simonbreit-dev/macroboard/electronics/makroboard.kicad_pcb

## KiCad design electronics/makroboard.kicad_pcb (2026-11-06)

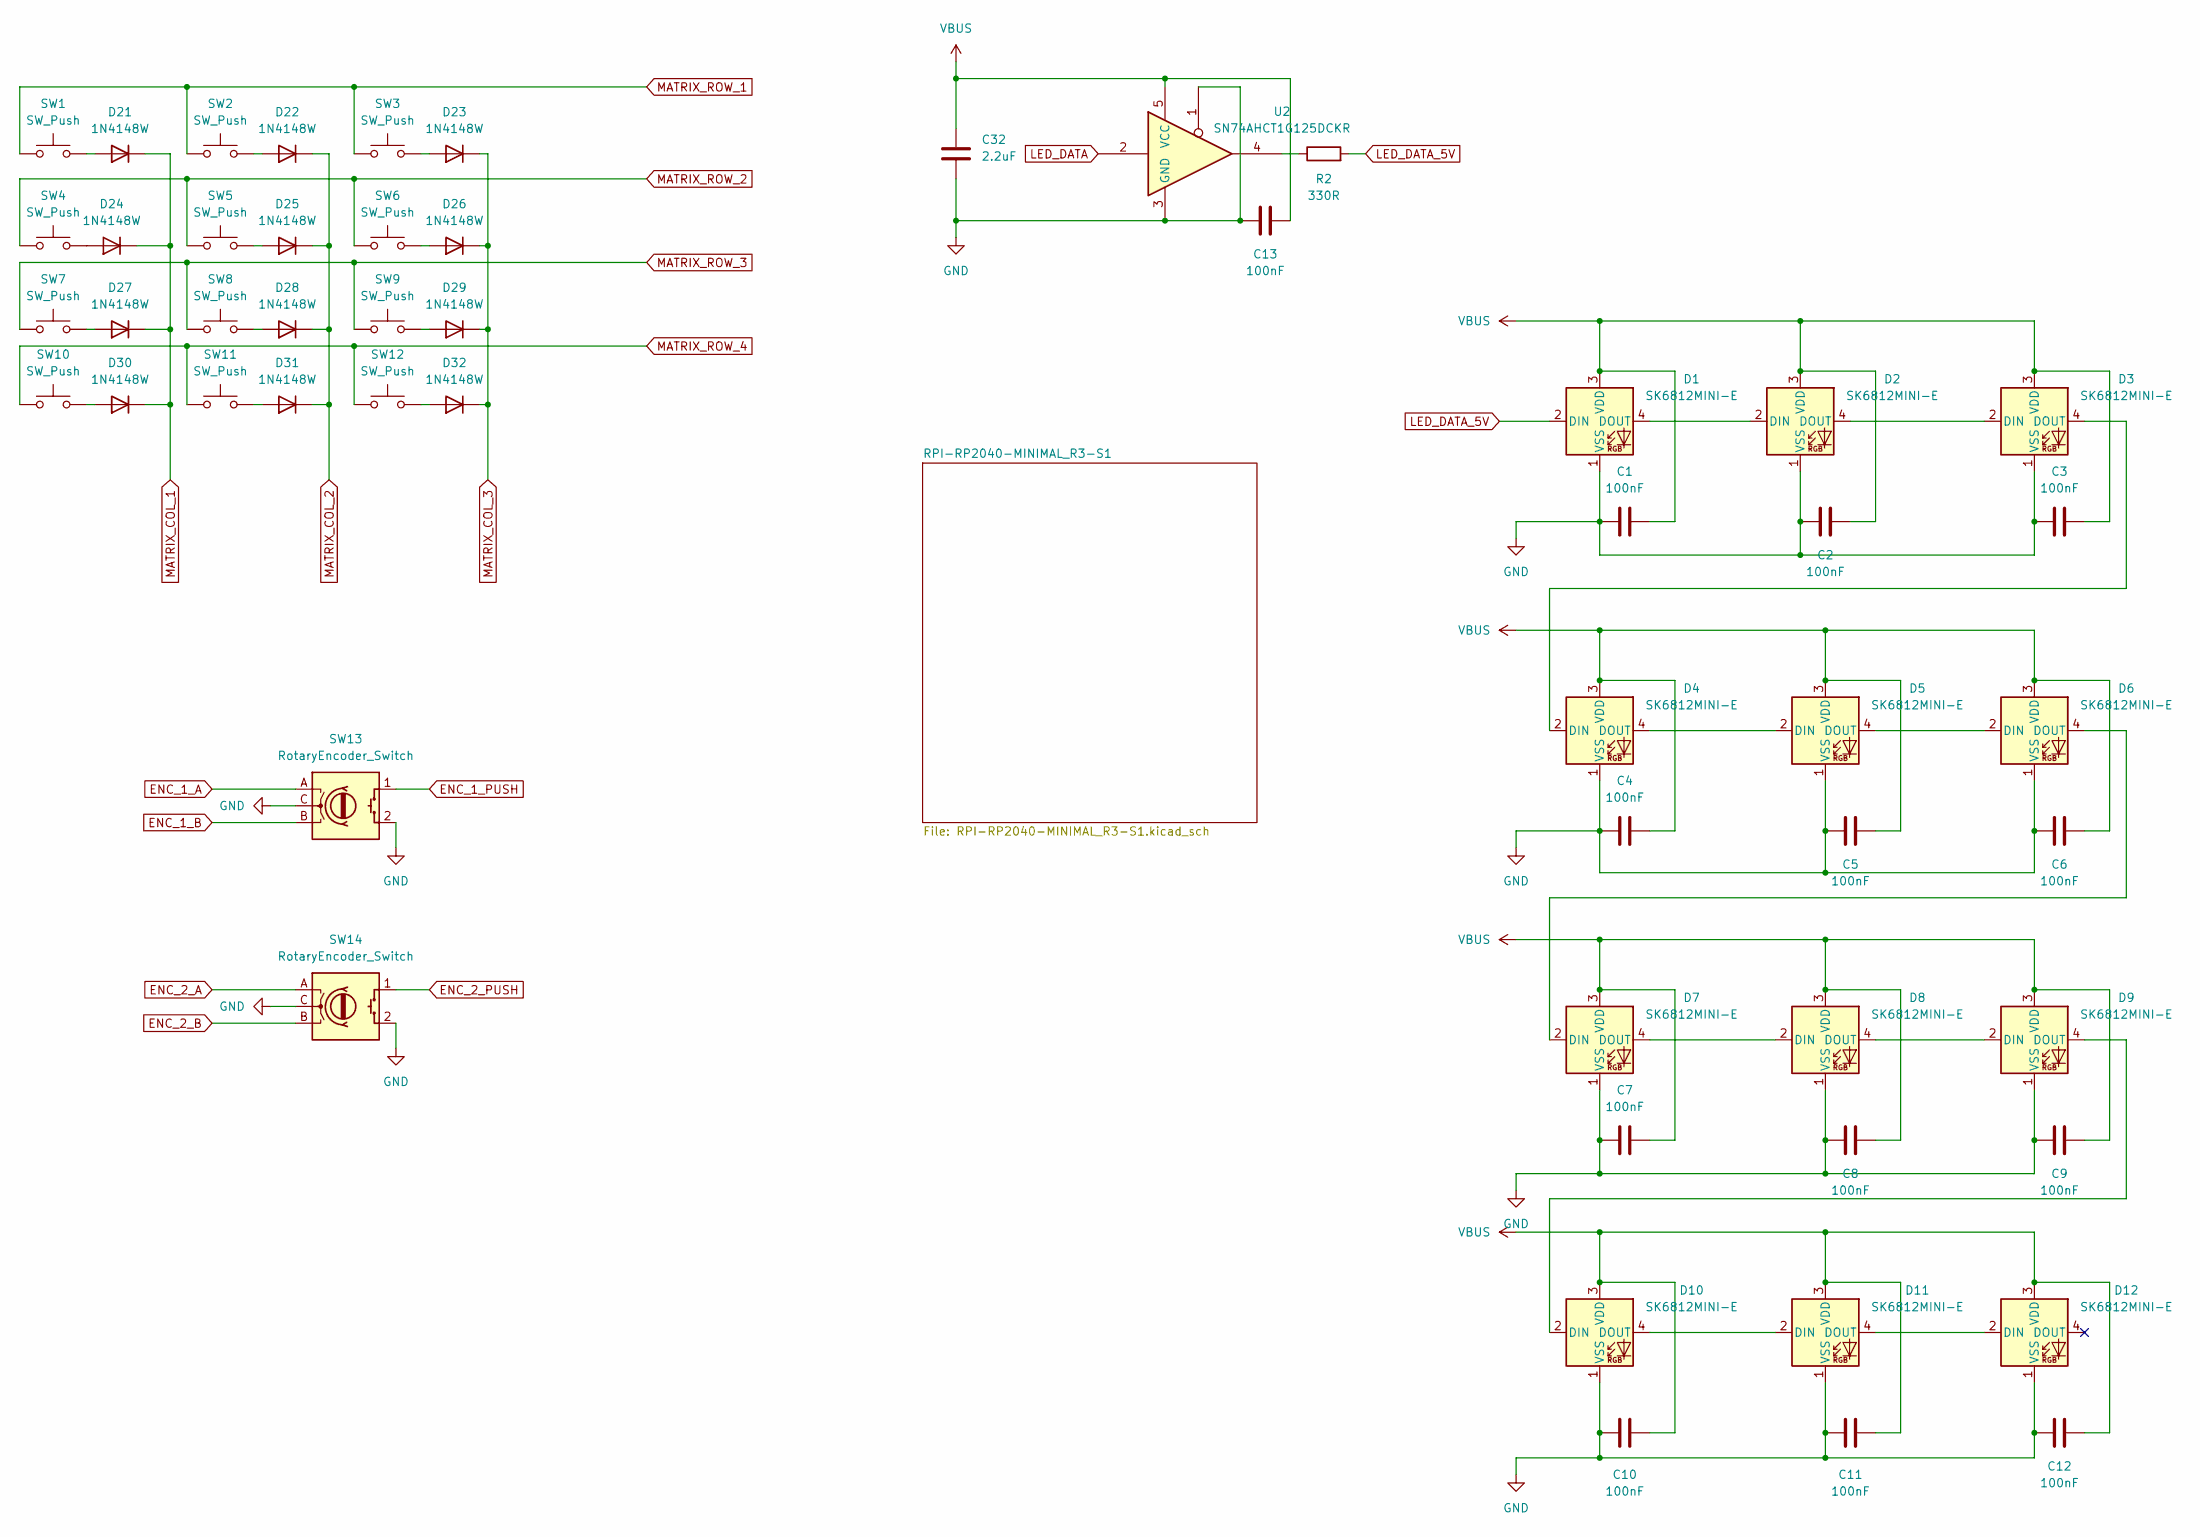
[picture p1: schematic makroboard.kicad_sch]

Parts:
C1: 100nF; C1_C_0805_2012Metric; manufacturer_pn CC0805KRX7R9BB104; LCSC C49678
C2: 100nF; C2_C_0805_2012Metric; manufacturer_pn CC0805KRX7R9BB104; LCSC C49678
C3: 100nF; C3_C_0805_2012Metric; manufacturer_pn CC0805KRX7R9BB104; LCSC C49678
C4: 100nF; C4_C_0805_2012Metric; manufacturer_pn CC0805KRX7R9BB104; LCSC C49678
C5: 100nF; C5_C_0805_2012Metric; manufacturer_pn CC0805KRX7R9BB104; LCSC C49678
C6: 100nF; C6_C_0805_2012Metric; manufacturer_pn CC0805KRX7R9BB104; LCSC C49678
C7: 100nF; C7_C_0805_2012Metric; manufacturer_pn CC0805KRX7R9BB104; LCSC C49678
C8: 100nF; C8_C_0805_2012Metric; manufacturer_pn CC0805KRX7R9BB104; LCSC C49678
C9: 100nF; C9_C_0805_2012Metric; manufacturer_pn CC0805KRX7R9BB104; LCSC C49678
C10: 100nF; C10_C_0805_2012Metric; manufacturer_pn CC0805KRX7R9BB104; LCSC C49678
C11: 100nF; C11_C_0805_2012Metric; manufacturer_pn CC0805KRX7R9BB104; LCSC C49678
C12: 100nF; C12_C_0805_2012Metric; manufacturer_pn CC0805KRX7R9BB104; LCSC C49678
C13: 100nF; C13_C_0805_2012Metric; manufacturer_pn CC0805KRX7R9BB104; LCSC C49678
C32: 2.2uF; C32_C_0805_2012Metric; manufacturer_pn CL21B225KOFNNNE; LCSC C28234
D1: SK6812MINI-E; D1_LED_SK6812MINI-E_3.2x2.8mm_P1.5mm_ReverseMount; manufacturer_pn SK6812MINI-E; LCSC C5149201
D2: SK6812MINI-E; D2_LED_SK6812MINI-E_3.2x2.8mm_P1.5mm_ReverseMount; manufacturer_pn SK6812MINI-E; LCSC C5149201
D3: SK6812MINI-E; D3_LED_SK6812MINI-E_3.2x2.8mm_P1.5mm_ReverseMount; manufacturer_pn SK6812MINI-E; LCSC C5149201
D4: SK6812MINI-E; D4_LED_SK6812MINI-E_3.2x2.8mm_P1.5mm_ReverseMount; manufacturer_pn SK6812MINI-E; LCSC C5149201
D5: SK6812MINI-E; D5_LED_SK6812MINI-E_3.2x2.8mm_P1.5mm_ReverseMount; manufacturer_pn SK6812MINI-E; LCSC C5149201
D6: SK6812MINI-E; D6_LED_SK6812MINI-E_3.2x2.8mm_P1.5mm_ReverseMount; manufacturer_pn SK6812MINI-E; LCSC C5149201
D7: SK6812MINI-E; D7_LED_SK6812MINI-E_3.2x2.8mm_P1.5mm_ReverseMount; manufacturer_pn SK6812MINI-E; LCSC C5149201
D8: SK6812MINI-E; D8_LED_SK6812MINI-E_3.2x2.8mm_P1.5mm_ReverseMount; manufacturer_pn SK6812MINI-E; LCSC C5149201
D9: SK6812MINI-E; D9_LED_SK6812MINI-E_3.2x2.8mm_P1.5mm_ReverseMount; manufacturer_pn SK6812MINI-E; LCSC C5149201
D10: SK6812MINI-E; D10_LED_SK6812MINI-E_3.2x2.8mm_P1.5mm_ReverseMount; manufacturer_pn SK6812MINI-E; LCSC C5149201
D11: SK6812MINI-E; D11_LED_SK6812MINI-E_3.2x2.8mm_P1.5mm_ReverseMount; manufacturer_pn SK6812MINI-E; LCSC C5149201
D12: SK6812MINI-E; D12_LED_SK6812MINI-E_3.2x2.8mm_P1.5mm_ReverseMount; manufacturer_pn SK6812MINI-E; LCSC C5149201
D21: 1N4148W; D21_D_SOD-123; manufacturer_pn 1N4148W; LCSC C81598
D22: 1N4148W; D22_D_SOD-123; manufacturer_pn 1N4148W; LCSC C81598
D23: 1N4148W; D23_D_SOD-123; manufacturer_pn 1N4148W; LCSC C81598
D24: 1N4148W; D24_D_SOD-123; manufacturer_pn 1N4148W; LCSC C81598
D25: 1N4148W; D25_D_SOD-123; manufacturer_pn 1N4148W; LCSC C81598
D26: 1N4148W; D26_D_SOD-123; manufacturer_pn 1N4148W; LCSC C81598
D27: 1N4148W; D27_D_SOD-123; manufacturer_pn 1N4148W; LCSC C81598
D28: 1N4148W; D28_D_SOD-123; manufacturer_pn 1N4148W; LCSC C81598
D29: 1N4148W; D29_D_SOD-123; manufacturer_pn 1N4148W; LCSC C81598
D30: 1N4148W; D30_D_SOD-123; manufacturer_pn 1N4148W; LCSC C81598
D31: 1N4148W; D31_D_SOD-123; manufacturer_pn 1N4148W; LCSC C81598
D32: 1N4148W; D32_D_SOD-123; manufacturer_pn 1N4148W; LCSC C81598
R2: 330R; R2_R_0805_2012Metric; manufacturer_pn 0805W8F3300T5E; LCSC C17630
SW1: SW_Push; SW1_SW_choc_v2_1u
SW2: SW_Push; SW2_SW_choc_v2_1u
SW3: SW_Push; SW3_SW_choc_v2_1u
SW4: SW_Push; SW4_SW_choc_v2_1u
SW5: SW_Push; SW5_SW_choc_v2_1u
SW6: SW_Push; SW6_SW_choc_v2_1u
SW7: SW_Push; SW7_SW_choc_v2_1u
SW8: SW_Push; SW8_SW_choc_v2_1u
SW9: SW_Push; SW9_SW_choc_v2_1u
SW10: SW_Push; SW10_SW_choc_v2_1u
SW11: SW_Push; SW11_SW_choc_v2_1u
SW12: SW_Push; SW12_SW_choc_v2_1u
SW13: RotaryEncoder_Switch; SW13_Bourns-PEC11R-4220F-S0024-0-0-0
SW14: RotaryEncoder_Switch; SW14_Bourns-PEC11R-4220F-S0024-0-0-0
U2: SN74AHCT1G125DCKR; U2_SOT-353_SC-70-5; manufacturer_pn SN74AHCT1G125DCKR; LCSC C350557

Connections:
ENC_1_A: SW13.A; also elsewhere on the board
ENC_1_B: SW13.B; also elsewhere on the board
ENC_1_PUSH: SW13.1 (S1); also elsewhere on the board
ENC_2_A: SW14.A; also elsewhere on the board
ENC_2_B: SW14.B; also elsewhere on the board
ENC_2_PUSH: SW14.1 (S1); also elsewhere on the board
GND: C1.2, C2.2, C3.2, C4.2, C5.2, C6.2, C7.2, C8.2, C9.2, C10.2, C11.2, C12.2, C13.2, C32.2, D1.1 (VSS), D2.1 (VSS), D3.1 (VSS), D4.1 (VSS), D5.1 (VSS), D6.1 (VSS), D7.1 (VSS), D8.1 (VSS), D9.1 (VSS), D10.1 (VSS), D11.1 (VSS), D12.1 (VSS), SW13.2 (S2), SW13.C, SW14.2 (S2), SW14.C, U2.1, U2.3 (GND); also elsewhere on the board
LED_DATA: U2.2; also elsewhere on the board
LED_DATA_5V: D1.2 (DIN), R2.2
MATRIX_COL_1: D21.1 (K), D24.1 (K), D27.1 (K), D30.1 (K); also elsewhere on the board
MATRIX_COL_2: D22.1 (K), D25.1 (K), D28.1 (K), D31.1 (K); also elsewhere on the board
MATRIX_COL_3: D23.1 (K), D26.1 (K), D29.1 (K), D32.1 (K); also elsewhere on the board
MATRIX_ROW_1: SW1.1, SW2.1, SW3.1; also elsewhere on the board
MATRIX_ROW_2: SW4.1, SW5.1, SW6.1; also elsewhere on the board
MATRIX_ROW_3: SW7.1, SW8.1, SW9.1; also elsewhere on the board
MATRIX_ROW_4: SW10.1, SW11.1, SW12.1; also elsewhere on the board
unnamed: D1.4 (DOUT), D2.2 (DIN)
unnamed: D2.4 (DOUT), D3.2 (DIN)
unnamed: D3.4 (DOUT), D4.2 (DIN)
unnamed: D4.4 (DOUT), D5.2 (DIN)
unnamed: D5.4 (DOUT), D6.2 (DIN)
unnamed: D6.4 (DOUT), D7.2 (DIN)
unnamed: D7.4 (DOUT), D8.2 (DIN)
unnamed: D8.4 (DOUT), D9.2 (DIN)
unnamed: D9.4 (DOUT), D10.2 (DIN)
unnamed: D10.4 (DOUT), D11.2 (DIN)
unnamed: D11.4 (DOUT), D12.2 (DIN)
unnamed: D21.2 (A), SW1.2
unnamed: D22.2 (A), SW2.2
unnamed: D23.2 (A), SW3.2
unnamed: D24.2 (A), SW4.2
unnamed: D25.2 (A), SW5.2
unnamed: D26.2 (A), SW6.2
unnamed: D27.2 (A), SW7.2
unnamed: D28.2 (A), SW8.2
unnamed: D29.2 (A), SW9.2
unnamed: D30.2 (A), SW10.2
unnamed: D31.2 (A), SW11.2
unnamed: D32.2 (A), SW12.2
unnamed: R2.1, U2.4
VBUS: C1.1, C2.1, C3.1, C4.1, C5.1, C6.1, C7.1, C8.1, C9.1, C10.1, C11.1, C12.1, C13.1, C32.1, D1.3 (VDD), D2.3 (VDD), D3.3 (VDD), D4.3 (VDD), D5.3 (VDD), D6.3 (VDD), D7.3 (VDD), D8.3 (VDD), D9.3 (VDD), D10.3 (VDD), D11.3 (VDD), D12.3 (VDD), U2.5 (VCC); also elsewhere on the board

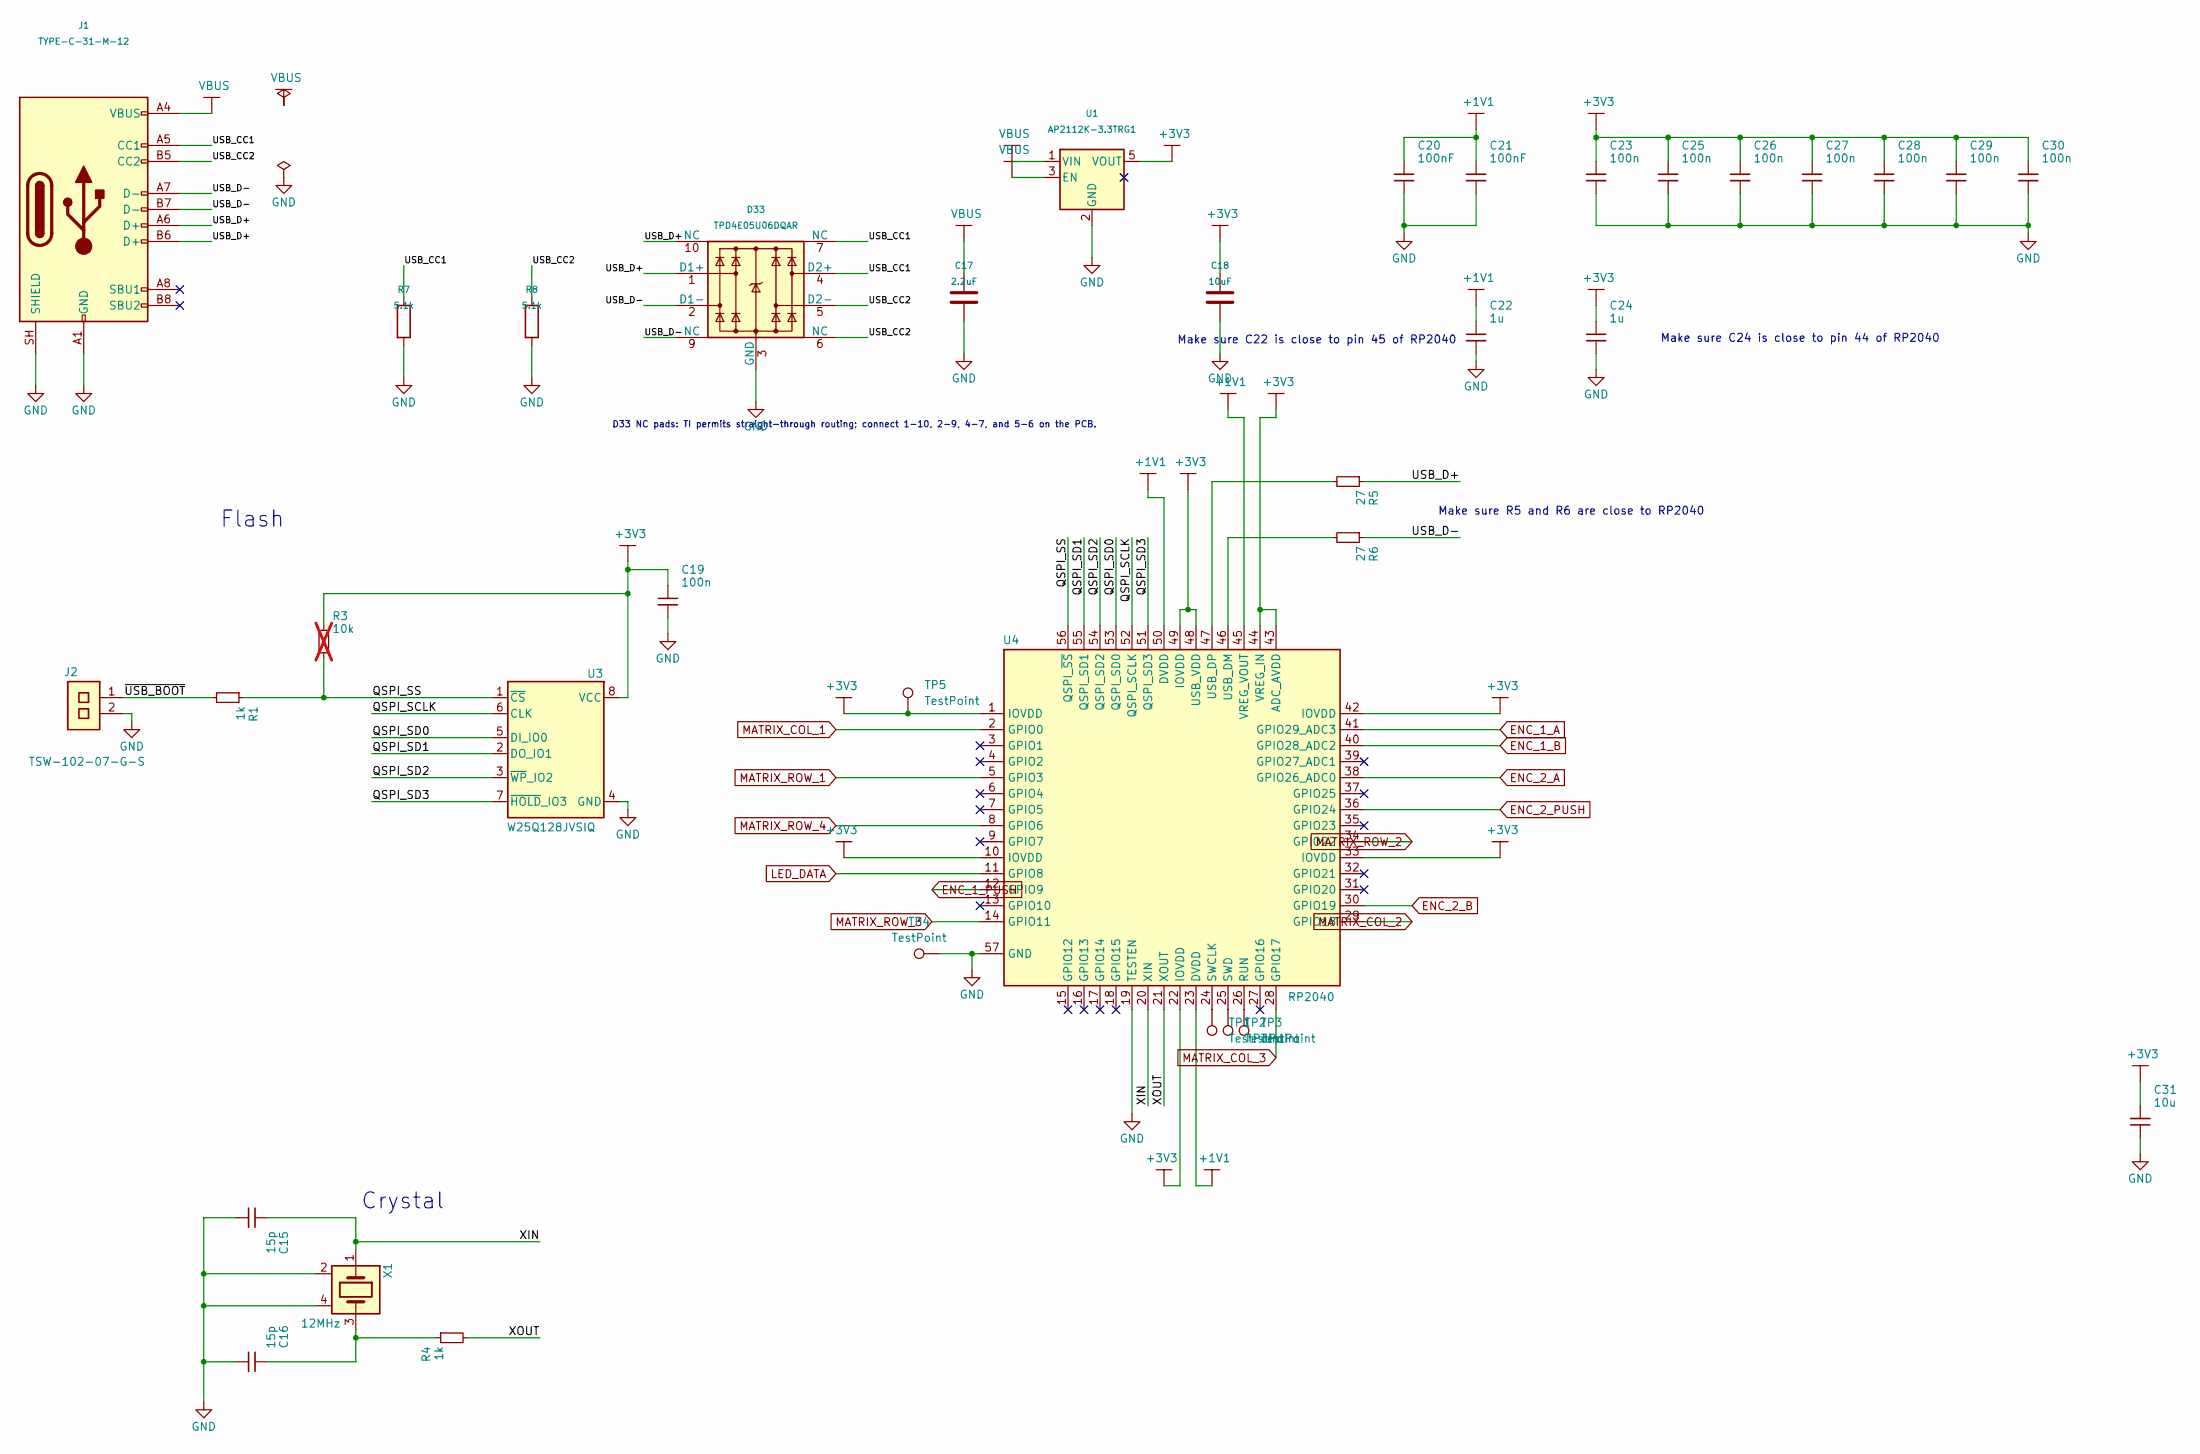
[picture p2: schematic RPI-RP2040-MINIMAL_R3-S1.kicad_sch, Makroboard - RP2040 controller]

Parts:
C15: 15p; C15_generic_capc1005x50; manufacturer_pn 0402CG150J500NT; LCSC C1548
C16: 15p; C16_generic_capc1005x50; manufacturer_pn 0402CG150J500NT; LCSC C1548
C17: 2.2uF; C17_generic_capc2012x125; manufacturer_pn CL21B225KOFNNNE; LCSC C28234
C18: 10uF; C18_generic_capc2012x125; manufacturer_pn CL21A106KAYNNNE; LCSC C15850
C19: 100n; C19_generic_capc1005x50; manufacturer_pn CL05B104KO5NNNC; LCSC C1525
C20: 100nF; C20_C_0805_2012Metric; manufacturer_pn CC0805KRX7R9BB104; LCSC C49678
C21: 100nF; C21_C_0805_2012Metric; manufacturer_pn CC0805KRX7R9BB104; LCSC C49678
C22: 1u; C22_generic_capc1005x50; manufacturer_pn CL05A105KA5NQNC; LCSC C52923
C23: 100n; C23_generic_capc1005x50; manufacturer_pn CL05B104KO5NNNC; LCSC C1525
C24: 1u; C24_generic_capc1005x50; manufacturer_pn CL05A105KA5NQNC; LCSC C52923
C25: 100n; C25_generic_capc1005x50; manufacturer_pn CL05B104KO5NNNC; LCSC C1525
C26: 100n; C26_generic_capc1005x50; manufacturer_pn CL05B104KO5NNNC; LCSC C1525
C27: 100n; C27_generic_capc1005x50; manufacturer_pn CL05B104KO5NNNC; LCSC C1525
C28: 100n; C28_generic_capc1005x50; manufacturer_pn CL05B104KO5NNNC; LCSC C1525
C29: 100n; C29_generic_capc1005x50; manufacturer_pn CL05B104KO5NNNC; LCSC C1525
C30: 100n; C30_generic_capc1005x50; manufacturer_pn CL05B104KO5NNNC; LCSC C1525
C31: 10u; C31_generic_capc2012x125; manufacturer_pn CL21A106KAYNNNE; LCSC C15850
D33: TPD4E05U06DQAR; D33_USON-10_2.5x1.0mm_P0.5mm; manufacturer_pn TPD4E05U06DQAR; LCSC C138714
J1: TYPE-C-31-M-12; J1_USB_C_Receptacle_HRO_TYPE-C-31-M-12; manufacturer_pn TYPE-C-31-M-12; LCSC C165948
J2: TSW-102-07-G-S; J2_samtec_tsw-102-07-g-s; part_uid RP-01JV5X-LY21H5
R1: 1k; R1_generic_resc1005x35; manufacturer_pn 0402WGF1001TCE; LCSC C11702
R3: 10k; R3_generic_resc1005x35; manufacturer_pn 0402WGF1002TCE; LCSC C25744; not fitted
R4: 1k; R4_generic_resc1005x35; manufacturer_pn 0402WGF1001TCE; LCSC C11702
R5: 27; R5_generic_resc1005x35; manufacturer_pn 0402WGF270JTCE; LCSC C25100
R6: 27; R6_generic_resc1005x35; manufacturer_pn 0402WGF270JTCE; LCSC C25100
R7: 5.1k; R7_R_0603_1608Metric; manufacturer_pn 0603WAF5101T5E; LCSC C23186
R8: 5.1k; R8_R_0603_1608Metric; manufacturer_pn 0603WAF5101T5E; LCSC C23186
TP1: TestPoint; TP1_TestPoint_Pad_D1.5mm
TP2: TestPoint; TP2_TestPoint_Pad_D1.5mm
TP3: TestPoint; TP3_TestPoint_Pad_D1.5mm
TP4: TestPoint; TP4_TestPoint_Pad_D1.5mm
TP5: TestPoint; TP5_TestPoint_Pad_D1.5mm
U1: AP2112K-3.3TRG1; U1_SOT-23-5; manufacturer_pn AP2112K-3.3TRG1; LCSC C51118
U3: W25Q128JVSIQ; U3_generic_soic127p790x195-8; manufacturer_pn W25Q128JVSIQ; LCSC C97521
U4: RP2040; U4_rpi_rp2040_vias; manufacturer_pn RP2040; LCSC C2040
X1: 12MHz; X1_generic_xtalcc320x250x80-4; manufacturer_pn ABM8-272-T3; LCSC C20625731

Connections:
+1V1: C20.1, C21.1, C22.1, U4.23 (DVDD), U4.45 (VREG_VOUT), U4.50 (DVDD)
+3V3: C18.1, C19.1, C23.1, C24.1, C25.1, C26.1, C27.1, C28.1, C29.1, C30.1, C31.1, R3.1, TP5.1 (1_1), U1.5 (VOUT), U3.8 (VCC), U4.1 (IOVDD), U4.10 (IOVDD), U4.22 (IOVDD), U4.33 (IOVDD), U4.42 (IOVDD), U4.43 (ADC_AVDD), U4.44 (VREG_IN), U4.48 (USB_VDD), U4.49 (IOVDD)
/RPI-RP2040-MINIMAL_R3-S1/QSPI_SCLK: U3.6 (CLK), U4.52 (QSPI_SCLK)
/RPI-RP2040-MINIMAL_R3-S1/QSPI_SD0: U3.5 (DI_IO0), U4.53 (QSPI_SD0)
/RPI-RP2040-MINIMAL_R3-S1/QSPI_SD1: U3.2 (DO_IO1), U4.55 (QSPI_SD1)
/RPI-RP2040-MINIMAL_R3-S1/QSPI_SD2: U3.3 (~WP_IO2), U4.54 (QSPI_SD2)
/RPI-RP2040-MINIMAL_R3-S1/QSPI_SD3: U3.7 (~HOLD_IO3), U4.51 (QSPI_SD3)
/RPI-RP2040-MINIMAL_R3-S1/QSPI_SS: R1.1, R3.2, U3.1 (~CS), U4.56 (QSPI_~SS)
/RPI-RP2040-MINIMAL_R3-S1/USB_CC1: D33.4 (D2+), D33.7 (NC), J1.A5 (CC1), R7.1
/RPI-RP2040-MINIMAL_R3-S1/USB_CC2: D33.5 (D2-), D33.6 (NC), J1.B5 (CC2), R8.1
/RPI-RP2040-MINIMAL_R3-S1/USB_D+: D33.1 (D1+), D33.10 (NC), J1.A6 (D+), J1.B6 (D+), R5.1
/RPI-RP2040-MINIMAL_R3-S1/USB_D-: D33.2 (D1-), D33.9 (NC), J1.A7 (D-), J1.B7 (D-), R6.1
/RPI-RP2040-MINIMAL_R3-S1/XIN: C15.1, U4.20 (XIN), X1.1
/RPI-RP2040-MINIMAL_R3-S1/XOUT: R4.2, U4.21 (XOUT)
/RPI-RP2040-MINIMAL_R3-S1/~USB_BOOT: J2.1, R1.2
ENC_1_A: U4.41 (GPIO29_ADC3); also elsewhere on the board
ENC_1_B: U4.40 (GPIO28_ADC2); also elsewhere on the board
ENC_1_PUSH: U4.12 (GPIO9); also elsewhere on the board
ENC_2_A: U4.38 (GPIO26_ADC0); also elsewhere on the board
ENC_2_B: U4.30 (GPIO19); also elsewhere on the board
ENC_2_PUSH: U4.36 (GPIO24); also elsewhere on the board
GND: C15.2, C16.2, C17.2, C18.2, C19.2, C20.2, C21.2, C22.2, C23.2, C24.2, C25.2, C26.2, C27.2, C28.2, C29.2, C30.2, C31.2, D33.3 (GND), D33.8 (GND), J1.A1 (GND), J1.A12 (GND), J1.B1 (GND), J1.B12 (GND), J1.SH (SHIELD), J2.2, R7.2, R8.2, TP4.1 (1_1), U1.2 (GND), U3.4 (GND), U4.19 (TESTEN), U4.57 (GND), X1.2, X1.4; also elsewhere on the board
LED_DATA: U4.11 (GPIO8); also elsewhere on the board
MATRIX_COL_1: U4.2 (GPIO0); also elsewhere on the board
MATRIX_COL_2: U4.29 (GPIO18); also elsewhere on the board
MATRIX_COL_3: U4.28 (GPIO17); also elsewhere on the board
MATRIX_ROW_1: U4.5 (GPIO3); also elsewhere on the board
MATRIX_ROW_2: U4.34 (GPIO22); also elsewhere on the board
MATRIX_ROW_3: U4.14 (GPIO11); also elsewhere on the board
MATRIX_ROW_4: U4.8 (GPIO6); also elsewhere on the board
unnamed: C16.1, R4.1, X1.3
unnamed: TP3.1 (1_1), U4.26 (RUN)
unnamed: TP1.1 (1_1), U4.24 (SWCLK)
unnamed: TP2.1 (1_1), U4.25 (SWD)
unnamed: R6.2, U4.46 (USB_DM)
unnamed: R5.2, U4.47 (USB_DP)
VBUS: C17.1, J1.A4 (VBUS), J1.A9 (VBUS), J1.B4 (VBUS), J1.B9 (VBUS), U1.1 (VIN), U1.3 (EN); also elsewhere on the board

Notes on the sheet:
Crystal
Make sure C22 is close to pin 45 of RP2040
Make sure C24 is close to pin 44 of RP2040
Make sure R5 and R6 are close to RP2040
Flash
D33 NC pads: TI permits straight-through routing; connect 1-10, 2-9, 4-7, and 5-6 on the PCB.

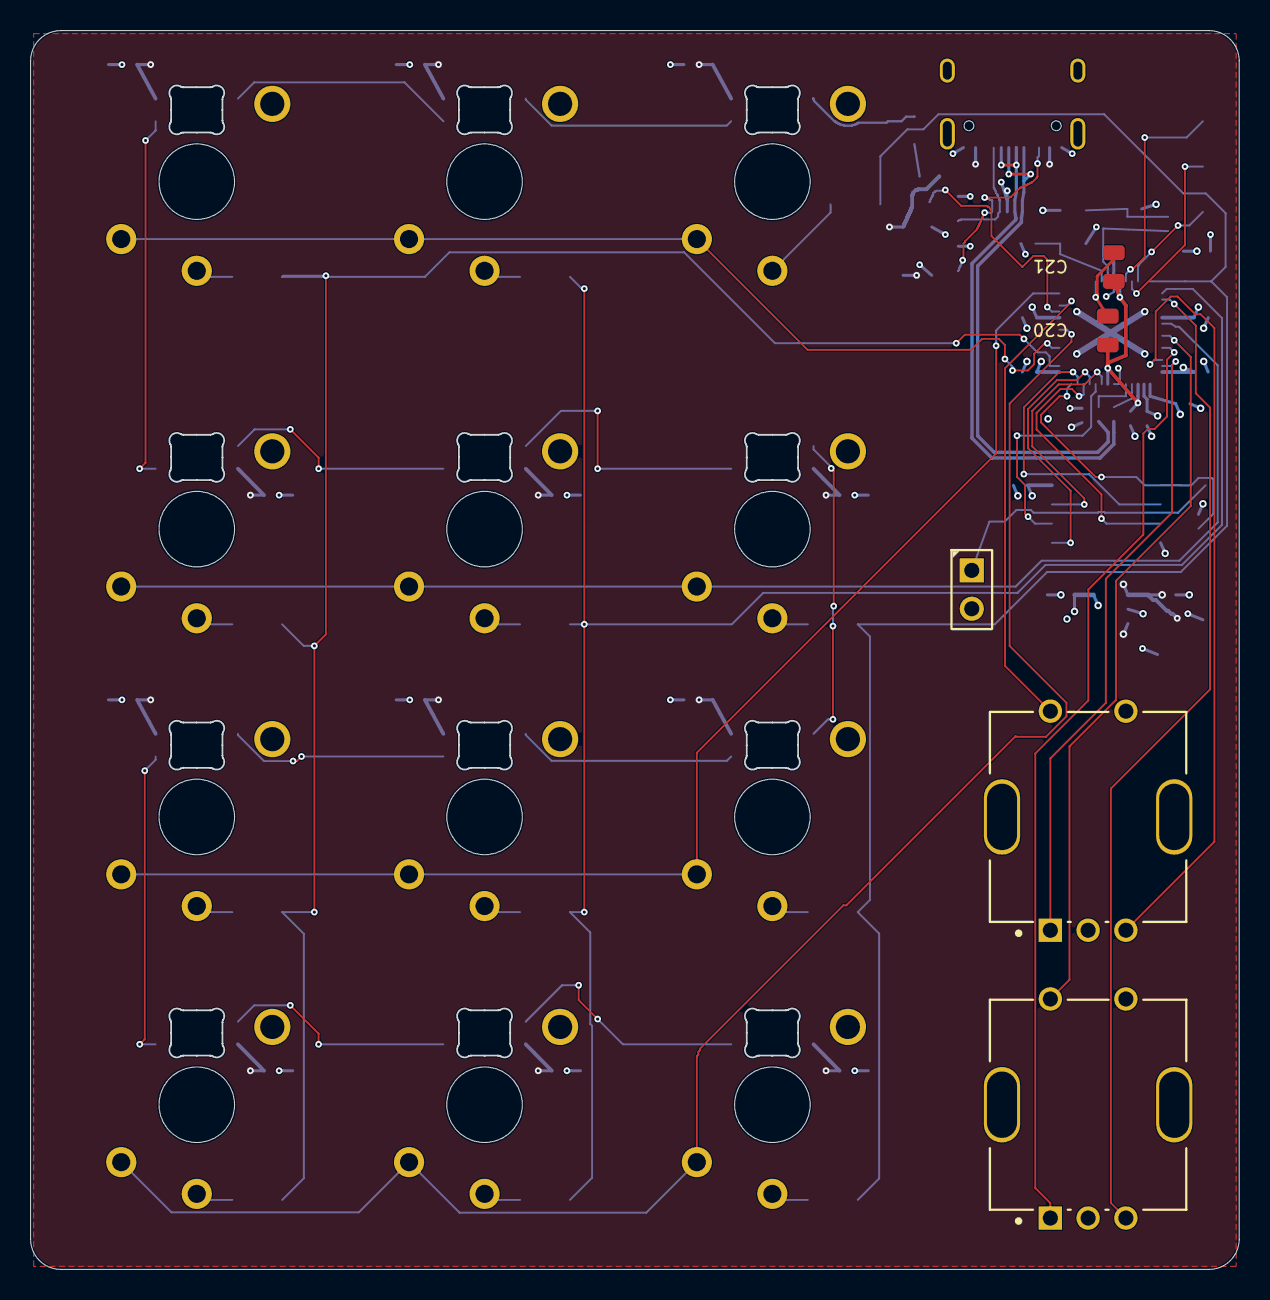
[picture p3: board makroboard.kicad_pcb from above]

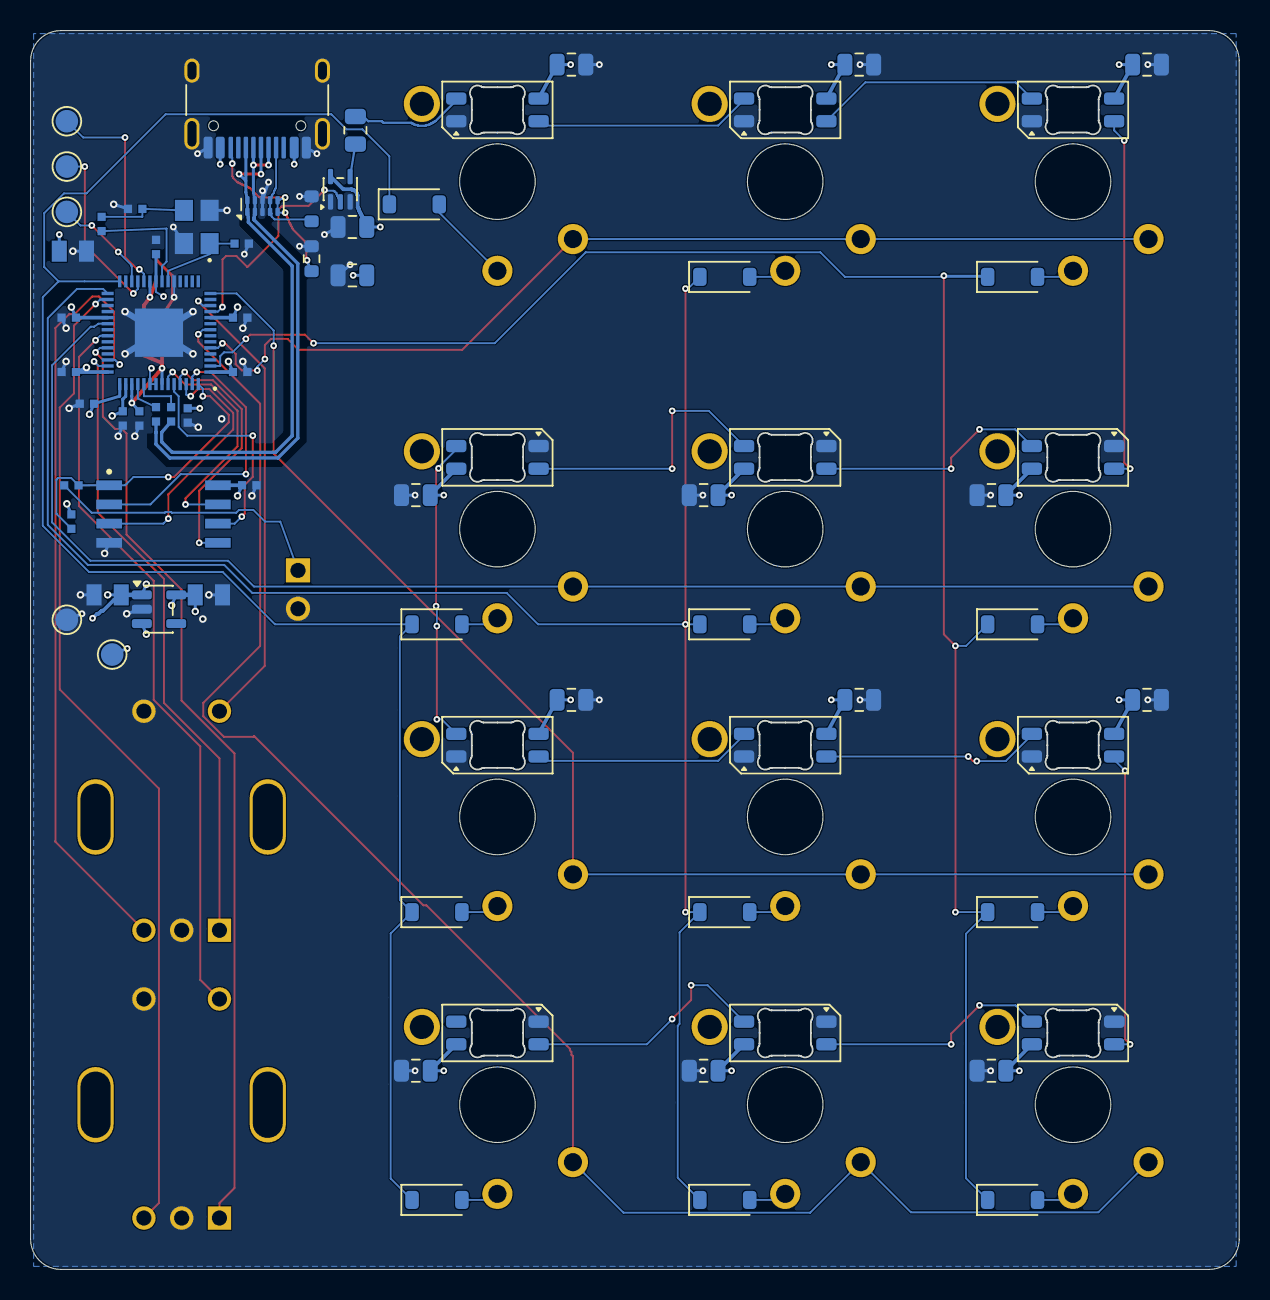
[picture p4: board makroboard.kicad_pcb from below]

Board: 4 copper layers, 80.0 x 82.0 mm, 90 parts (73 on the bottom side), 62 nets.
