simonbreit-dev/macroboard/(notices)

Notices in the files:
electronics/makroboard.kicad_pcb:
Makroboard modifications: Copyright 2026 Simon Breit
CERN-OHL-P-2.0; see ../THIRD_PARTY.md for third-party notices
